OptogeneticsandNeuralEngineeringCore/MicroscopeCamera/Housing Top.stl

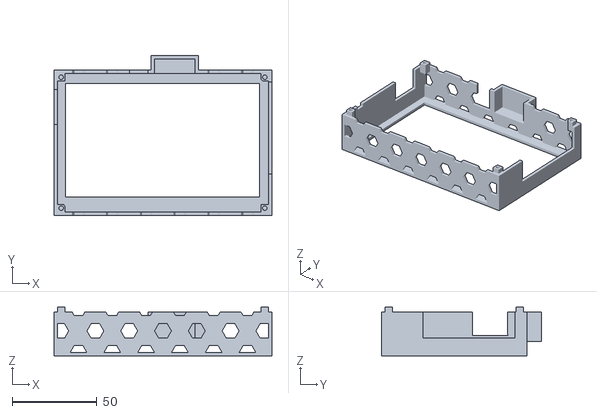
[picture p1: CAD file, 2018-03-12]
Housing Top.stl
129.0 x 94.5 x 29.0
