OptogeneticsandNeuralEngineeringCore/MicroscopeCamera/Microscope Eyepiece Holder Ball.stl

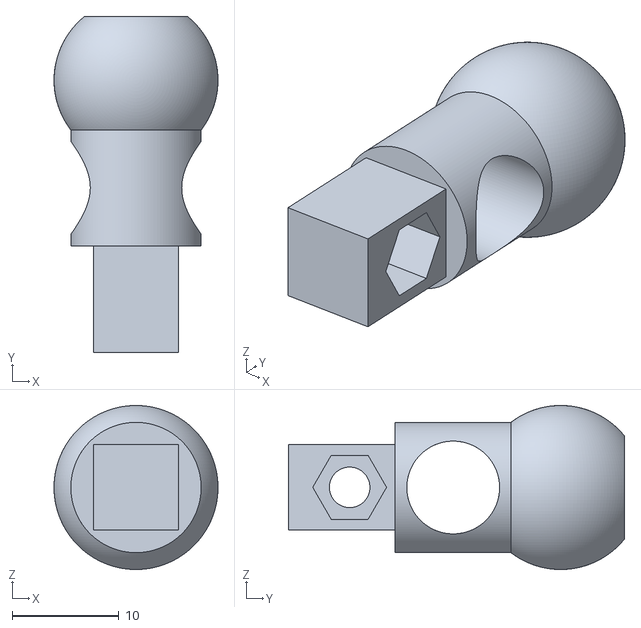
[picture p2: CAD file, 2018-03-12]
Microscope Eyepiece Holder Ball.stl
15.4 x 31.5 x 15.4
