OptogeneticsandNeuralEngineeringCore/MicroscopeCamera/Stylis holder.stl

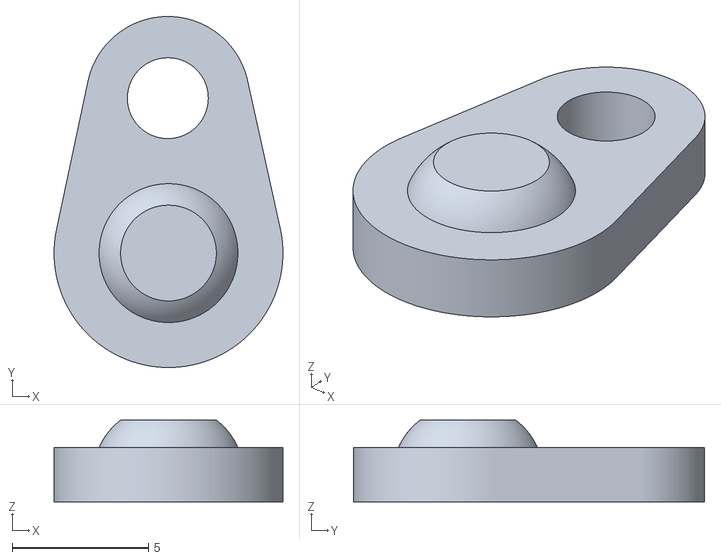
[picture p3: CAD file, 2018-03-12]
Stylis holder.stl
8.41 x 12.9 x 3.00
