OptogeneticsandNeuralEngineeringCore/MicroscopeCamera/Microscope Eyepiece Holder Grips.stl

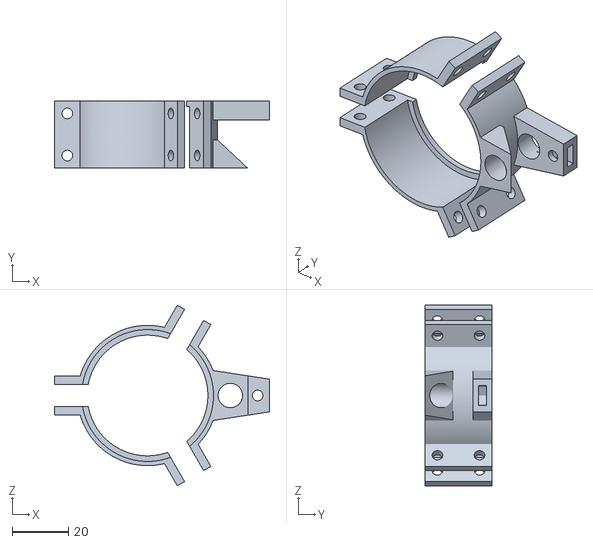
[picture p4: CAD file, 2018-03-12]
Microscope Eyepiece Holder Grips.stl
76.6 x 24.0 x 64.4
