OptogeneticsandNeuralEngineeringCore/MicroscopeCamera/Microscope Eyepiece Holder Back.stl

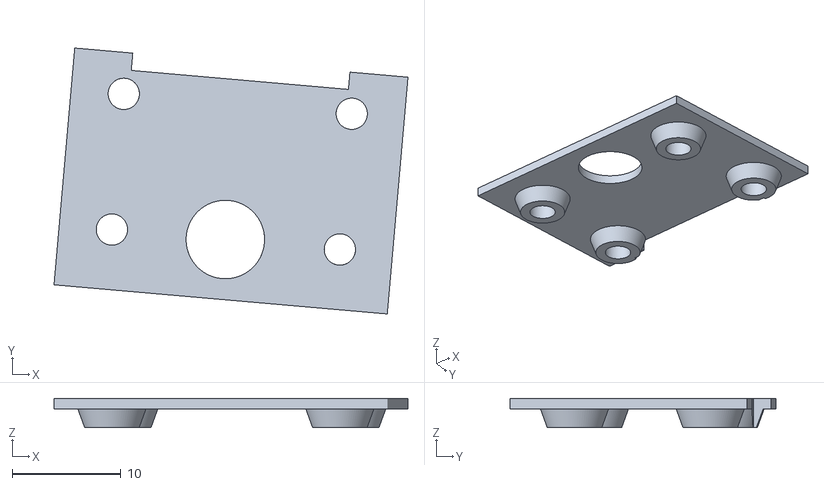
[picture p5: CAD file, 2018-03-12]
Microscope Eyepiece Holder Back.stl
32.5 x 24.4 x 2.70
