OptogeneticsandNeuralEngineeringCore/MicroscopeCamera/Housing Bottom.stl

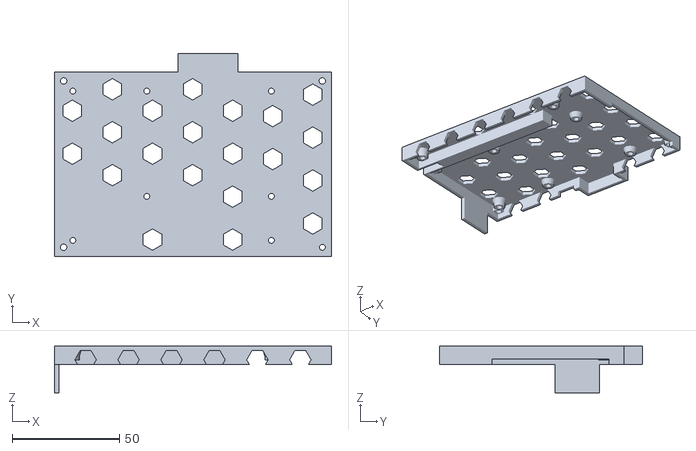
[picture p6: CAD file, 2018-03-12]
Housing Bottom.stl
129.0 x 94.5 x 21.7
