OptogeneticsandNeuralEngineeringCore/MicroscopeCamera/Microscope Eyepiece Holder Cup.stl

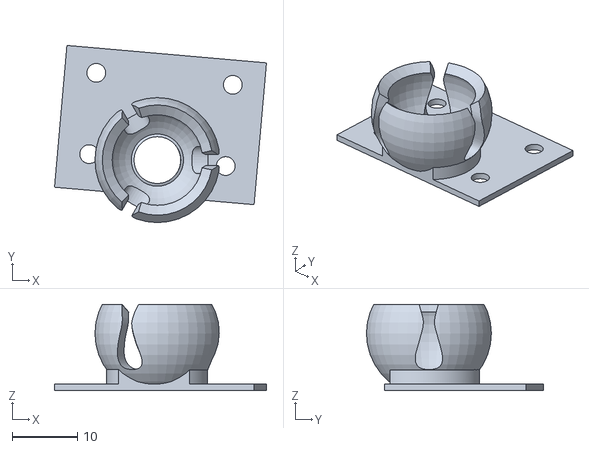
[picture p7: CAD file, 2018-03-12]
Microscope Eyepiece Holder Cup.stl
32.5 x 27.1 x 13.2
