OptogeneticsandNeuralEngineeringCore/MicroscopeCamera/Microscope Eyepiece Holder El L.stl

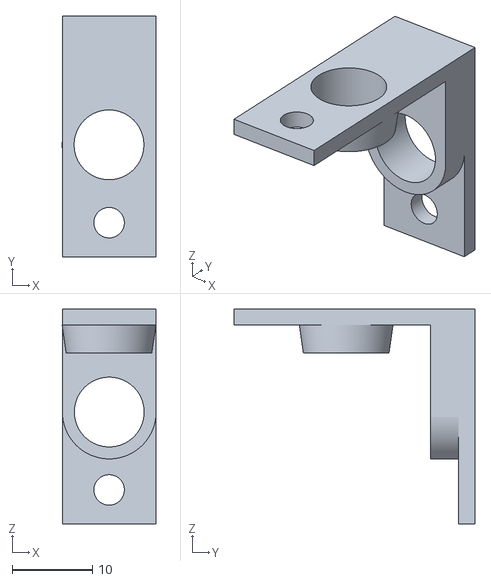
[picture p8: CAD file, 2018-03-12]
Microscope Eyepiece Holder El L.stl
11.7 x 30.0 x 26.8
