OptogeneticsandNeuralEngineeringCore/MicroscopeCamera/(list of files, cad)

Other CAD files:
Housing Bottom.ipt
Housing Top.ipt
Microscope Eyepiece Holder Back.ipt
Microscope Eyepiece Holder Ball.ipt
Microscope Eyepiece Holder Cup.ipt
Microscope Eyepiece Holder El L.ipt
Microscope Eyepiece Holder Grips.ipt
Stylis holder.ipt
