OptogeneticsandNeuralEngineeringCore/MicroscopeCamera/(commit log)

2018-03-12 Uploada da filez
    [Housing Bottom.ipt, Housing Bottom.stl, Housing Top.ipt, Housing Top.stl, Microscope Eyepiece Holder Back.ipt, Microscope Eyepiece Holder Back.stl, Microscope Eyepiece Holder Ball.ipt, Microscope Eyepiece Holder Ball.stl]
2018-03-13 Add the assembly instructions
